13982720426/MimiVent-firmware/CHANGELOG.md

# 更新记录

## [0.7.0] - 2026-11-13

- 版本从主分支 `v0.6.0` 递增；该版本汇总开发期尚未进入主分支的 MQTT、存储和 OTA 改进。
- 移除设备 HTTPS 服务及 TLS 资源开销；BLE 配网保留，WiFi 控制、查询和校时经本地 MQTT/NAS 完成，最低 App 版本设为 `v0.7.0`。
- MQTT 控制使用两阶段握手、短时凭据、设备去重记录和控制租约；改进 ACK、状态新鲜度、查询分片和查询槽释放，避免控制或分页查询被积压阻塞。
- 优化统计查询分片、状态上报和重连快照；修复统计时间校准及跨日活动归档问题，旧存储 schema 继续兼容迁移。
- 缩小 BLE OTA 队列及统计记录常驻内存，降低 MQTT 常驻时的堆压力；完整包 OTA 工作区降低内存需求，错误信息增加内存诊断值。
- 保持 OTA 包格式和分区布局兼容；统计存储 schema 8 兼容读取旧 schema 4/6/7。

## 开发阶段构建记录（未发布到主分支；版本号仅用于开发测试）

### 开发构建 [0.7.16] - 2026-11-11

- 统计存储 schema 8：DailyRecord 的 runtimeBuckets / activitySpanBuckets 由 uint32_t 收窄为 uint16_t。单小时最多 3600 秒，uint16 足够；异常计时超限时饱和到 65535 而不回绕。单日记录 312 B → 216 B，30 天常驻省 2,880 B。
- 读取侧兼容 schema 4/6/7/8：旧记录逐条读入局部变量后转换，CRC 仍按文件原始字节校验，不额外占用整块缓冲。
- 累计后静态 RAM 由 74,944 B 降到 72,064 B。
- 不改变 OTA 包格式或分区布局。

### 开发构建 [0.7.15] - 2026-11-11

- BLE OTA 控制队列改为专用 326 B 消息结构（原按 518 B 通用结构分配），8 格队列由 4,144 B 降到 2,608 B。
- OTA 数据队列深度 12 → 6、控制队列 8 → 3，合计再释放约 4.7 KB 常驻堆；协议窗口 window=4 保持不变。
- 控制指令接口保持 receiveControl(Message*) 不变，接收端按实际长度拷贝，上层无改动。
- ControlApi 响应新增右值重载，统计查询不再为整份响应额外分配一份堆副本。
- 新增 [mem] 周期日志（free/largest/min 同 capability），便于观察运行期内存基线。
- 不改变统计存储 schema、OTA 包格式或分区布局。

### 开发构建 [0.7.14] - 2026-11-11

- 最低 App 版本提升到 v0.7.6：设备 HTTPS 已于 0.7.12 移除，控制只能走 NAS MQTT，而 v0.7.6 是首个完整支持该通道的 App。旧 App 会在状态版本检查与旧式 BLE 请求两处收到 APP_UPDATE_REQUIRED。
- 完整包 OTA 块大小从 16 KB 降到 8 KB，总内存需求由约 43 KB 降到约 27 KB，避免在 MQTT 常驻 + BLE 连接时触发 ERROR|MEMORY。
- OTA 内存失败时错误码携带 block/free/largest 实际数字，便于区分容量不足与碎片。
- 不改变统计存储 schema、OTA 包格式或分区布局。

### 开发构建 [0.7.13] - 2026-11-11

- 统计查询回复分片从 128 B 提升到 1024 B。原先一份 2.5 KB 的统计要拆 20 片且每片都要等设备 ACK 才发下一片，统计页因此比控制慢一个数量级；现在片数降到 3 片。
- 单片载荷经核算为 1224 B，仍在 1536 B 单条上限内，不改变 MQTT 信封格式或分片协议。
- 不改变统计存储 schema、OTA 包格式或分区布局。

### 开发构建 [0.7.12] - 2026-11-09

- 蓝牙校时覆盖 NAS 来源后，当前 MQTT 会话会重新向 NAS 取时，避免停留在手机时间来源。

### 开发构建 [0.7.11] - 2026-11-07

- 统计响应新增当前启动内最近一次成功校时来源（phone/nas/none），方便区分 BLE 与 NAS MQTT 校时。
- 不改变统计存储 schema、OTA 包格式或分区布局。

### 开发构建 [0.7.10] - 2026-11-07

- 活动合并间隔和持续时间改用当前启动内的单调计时，避免校时回拨/跳变造成活动被拆分或时长错误。
- 日桶按活动起点 UTC 锚点加单调跨度映射；回拨时保留事件顺序并标记 `clockWentBackwards`。
- 统计存储 schema、OTA 包格式和分区布局不变。

### 开发构建 [0.7.9] - 2026-11-07

- 修正 MQTT 状态入队预算：为 1 KiB 状态负载额外预留 topic 与 MQTT 包头空间，避免消息在进入 outbox 前被持续拒绝。
- 为最大状态负载增加原生回归测试；控制回执仍保留独立队列预算。

### 开发构建 [0.7.8] - 2026-11-07

- MQTT 状态改用 schema 1 信封，携带 deviceId、bootId、32 位 seq 和单调 uptime；原状态字段保留在 state 内。
- 状态变化后快速上报，空闲时每 5 秒发送一次心跳；运行计时变化不推进状态序号。
- MQTT 重连后主动发布完整快照，超出 1 KiB 的状态拒绝发送并记录诊断。
- 统计 schema、OTA 包格式及分区布局不变。

### 开发构建 [0.7.7] - 2026-11-07

- MQTT 两阶段控制的 HMAC challenge 密钥改为每次设备启动生成一次，避免短暂 MQTT 重连发生在 prepare/execute 之间时误报 `COMMAND_EXPIRED`。
- 保持 challenge 的 1 秒有效期、绑定 token 校验、去重与统计 schema 不变。

### 开发构建 [0.7.6] - 2026-11-07

- 删除 ESP32 HTTPS 服务、TLS 资源探针及专属构建包装；BLE 配网保留，WiFi 控制与读取仅经 MQTT/NAS。
- 将 MQTT 写控制、绑定更新及去重恢复移到独立控制服务，不再依赖 HTTP 服务生命周期。
- WiFi 状态返回 MQTT 配置和连接状态；现场绑定/OTA 回归脚本据此等待 MQTT 就绪。
- 保持统计 schema、OTA 包格式及分区布局不变；本版本已部署到真机。

### 开发构建 [0.7.5] - 2026-11-07

- MQTT-only 构建的设备能力明确声明 MQTT 控制、只读查询和校时，不再把它们错误绑定到已关闭的板载 HTTPS 服务。
- 设备能力描述编译期支持；在线状态继续由独立连接字段表达。
- NAS 仅提供 UTC 与时间质量，不再把主机时区传给设备；统计时区未由 BLE/授权流程固定前，设备延迟采纳 NAS 校时。
- 统计 schema、OTA 包格式和分区布局不变。

### 开发构建 [0.7.4] - 2026-11-07

- MQTT 只读统计响应改为 128 字节分片、逐片确认，支持最多 8 KiB 的 JSON 响应并限制单包在 1 KiB 内。
- 统计响应在设备侧转移字符串所有权，避免为大响应额外解析出一棵完整 cJSON 树。
- 统计 schema、OTA 包格式和分区布局不变。

### 开发构建 [0.7.3] - 2026-11-07

- NAS MQTT 两阶段控制增加定时设置保存；继续复用绑定授权、短时 challenge、写入去重和控制互斥锁。
- 统计 schema、OTA 包格式和分区布局不变。

### 开发构建 [0.7.2] - 2026-11-07

- BLE OTA 分配签名包解码工作区前主动释放 MQTT 客户端和队列堆占用，恢复路径仍由主循环自动重连。
- OTA 开始前登记当前授权 BLE 会话为任务 owner，内存准备失败时仍可查询明确终态，不遗留 `NOT_OWNER`。
- 统计 schema、OTA 包格式和分区布局不变。

### 开发构建 [0.7.1] - 2026-11-07

- MQTT 状态心跳调整为 5 秒，并在状态快照中携带有效绑定的 token 哈希摘要，供 NAS 续期只读缓存授权；不发送明文 token。
- 保持设备 HTTPS 在 WiFi/MQTT 构建中关闭；MQTT 发送队列仍为有界，控制 ACK 保留预算。
- 统计 schema 与 OTA 分区布局不变。

### 开发构建 [0.7.0] - 2026-11-06

- 修复 NAS 控制因 NVS 去重记录空间不足返回 503：迁移到 statistics 文件分区独立双槽，写后校验再执行，保留原有配置及统计数据。
- BLE + MQTT 构建关闭设备 HTTPS，减少通信内存占用；NAS 不可用时使用蓝牙。

- 增加局域网 NAS MQTT 控制，BLE 配置 Broker，设备计时签发短时凭据并校验订阅就绪状态。
- MQTT 与 HTTPS 共用控制租约和持久去重记录；增加正文摘要校验，兼容旧记录查询。
- 限制 MQTT 发送队列占用，记录入队失败，避免网络积压影响本地自动控制。
- 保持统计 schema 7 和现有 OTA 分区布局，保留 WiFi/BLE 直连能力。

## [0.6.0] - 2026-11-05

### 变更
- 统计存储 schema 6 → 7：事件容量由 512 降到 256，快照字节数 19,656 → 14,536。
- 升级时自动迁移：按旧上限读取 schema 6 快照、截断到 256 条后按新布局落盘，30 天日汇总完整保留。
- 事件明细实际覆盖范围约 3 天，App 的明细入口同步收敛到今天/昨天/前天。
- 入厕样本时长改取该次排风对应的感应活动跨度，不再用排风时长；无前置活动时不计样本。
- 排风开始时快照活动跨度，避免排风期间 PIR 再次触发把这次样本清零。
- 跨午夜的活动整段归入开始日，入厕样本同样按活动开始日归属，日汇总与样本不再落在不同日期。

### 修复
- schema 6 → 7 缩容迁移保留最新 256 条事件，丢弃头部记录时推进 droppedThrough，全部原始事件仍参与 CRC 校验。
- 范围统计响应补充 deviceId/dataEpoch，供 App 隔离设备和统计批次缓存。
- 统计范围查询响应精简为短键（`cov/bits/rt/span/trig/seg`），不可用字段整段省略，单日响应约 5.1 KB 降到 3 KB。
- WiFi HTTPS 服务的堆门槛由 56 KB 降到 48 KB，TLS 栈 16 KB 降到 10 KB，双栈驻留时不再握手失败。
- 事件数组缩小后空闲堆由 18 KB 提升到 42 KB，`largest` 由 7.7 KB 提升到 32 KB。
- 固件要求的最低 App 版本提升到 0.6.0（更早的 App 不认识短键统计 JSON，会把所有桶读成 0）。

## [0.5.1] - 2026-11-04

### 修复
- WiFi 绑定记录从 2 槽 v1 格式无损迁移到 3 槽 v2 格式，升级后保留现有两台手机绑定。
- 第 3 个 WiFi 客户端可正常绑定；第 4 个才返回 `BINDINGS_FULL`。

### 变更
- 统计响应增加 toiletAverageSeconds 和 toiletSampleCount，按全部自动排风有效样本汇总平均入厕时间。
- 设备端 WiFi 绑定上限由 2 个提升到 3 个。

## [0.5.0] - 2026-11-03

本节汇总自正式版 v0.4.0 以来的变化；开发调试版本不单独列为正式发布。本次版本已完成用户真机验证。

### 新增

- WiFi STA 配网，通过加密且已 bonding 的独立 BLE 服务下发凭据，NVS 保存、开机恢复；附近网络由手机搜索，设备端不执行 WiFi 扫描。
- HTTPS 8443 局域网控制，状态、时序设置、风机操作、统计及事件查询复用 `ControlApi`，并提供写请求 ID 去重与执行结果查询。
- 持久设备身份、证书与 token 认证，最多三个有效绑定，支持绑定窗口、待绑定、核验、幂等提交、逐个撤销和安全 BLE 清除全部绑定。
- WiFi 单控制者租约与 BLE 业务协调，租约空闲 20 秒过期，支持主动释放、另一手机接管和绑定重置后释放。
- 自动排风记录保存设定时长，统计接口增加 `toiletCount` 估算；实际自动排风达到设定时长一半时计入，手动/强制排风排除。

### 优化与修正

- 提供项目构建模式与隔离 TLS 4 KiB SDK 副本校验，控制 BLE/WiFi 共存资源占用，不覆盖全局 SDK；完整 WiFi 控制使用 `read4k` 模式。
- OTA 工作区按需分配，内存不足时释放 HTTPS、必要时暂停 WiFi；暂停及升级流程结束后恢复网络服务，保留原有签名与分区校验。
- 安全 BLE 与普通控制请求隔离、会话关联及有界响应，改善配对、重连、通知超时后的恢复。
- USB CDC 日志采用非阻塞输出，避免主机不读取串口时拖慢 BLE 初始化和响应。
- HTTPS 单连接及有界请求调度、WiFi 省电策略和租约协调，减少多手机竞争、控制延迟和资源占用。
- WiFi 身份与绑定持久化、存储余量检查及显式维护入口，避免创建绑定挤占 OTA 检查点空间；敏感凭据不写日志。

### 兼容与限制

- 最低 BLE v2 App 仍为 0.3.0；完整配网、WiFi 控制与统计展示配套 App v0.5.0。
- 保留 schema 4、双槽统计、30 天汇总和最多 10 天/512 条明细；预计入厕依赖仍保留的自动排风记录，不是独立永久日汇总。
- 保留 v0.4.0 的签名完整/压缩/差分 BLE OTA、暂停续传、独立安装与重连核验；本版不提供 WiFi OTA、SoftAP 网页或云端控制。

## [0.4.0] - 2026-10-30

- 修复备用槽已有固件时的 OTA 续传擦除；能力与镜像信息查询不再覆盖任务状态，QUERY 可恢复待安装结果及失败原因。
- 统计格式升级为 schema 4：每小时独立累计运行时长，汇总和各范围图表从同一组小时桶生成；超过 512 条明细后仍保留完整运行汇总，接口返回明细截断标记。
- 独立保存当前运行身份，避免 PIR 明细淘汰导致停止时漏结算；优先保留待校时运行记录，首次校时可回填。
- 开发期旧格式统计在首次启动 schema 4 时重建，并切换 dataEpoch；设备设置与 OTA 任务保留。

- 从正式版 v0.3.1 首次迁移到新分区布局和 BLE OTA V2 时需通过 USB 烧录；后续版本可经 App 无线升级。
- 固件声明最低兼容 App 为 `0.3.0`；旧 BLE v1 请求返回 `426 APP_UPDATE_REQUIRED`。控制协议切换为 BLE v2。
- BLE OTA 采用签名包、流控窗口、完整校验、独立安装确认和重连身份核验；断连后以设备有效检查点续传。
- 增加 OTA 分区运行时串口清单，便于验收实际生效的分区布局与目标 OTA 槽。
- 修复设备回滚状态被连接初始化覆盖的问题；查询时从持久拒绝记录恢复回滚任务身份。
- 修复安装意图写入后、启动槽切换前断电会误拒绝放弃/替换的问题；根据实际启动分区判断是否已提交安装。

### 修正
- 修复 miniz 解压头文件格式，恢复固件编译。
- OTA 压缩包与差分包头改为按声明长度安全解析版本和分区字段。
- 统计时区在首次可信校时后固定，避免手机时区变化重解释历史日汇总。
- 今日事件窗口使用本地自然日，接口返回固定查询起止时间；昨日继续使用前一自然日。
- 首次验证和时序配置说明改为使用 MimiVent App 的 BLE 流程。

### 新增
- 移除设备 SoftAP、HTTP 控制台及固件内嵌网页，设备控制统一使用 BLE；为后续 Wi-Fi STA 传输层保留公共业务接口。
- 事件记录新增单调递增 ID 和 `beforeId` 游标分页，旧版 SPIFFS 统计数据迁移 ID 时保留历史；事件 API 返回稳定游标并兼容旧 App 的 `offset` 参数。
- 增加 BLE OTA 固件升级，镜像分块写入备用 OTA 应用槽，逐块校验 CRC-32，完成后校验 SHA-256。
- App 可选择并识别 MimiVent ESP32-C3 固件镜像，显示传输进度；升级失败、超时或 BLE 断开时中止并恢复自动感应。
- OTA 期间风机强制关闭，镜像通过设备型号校验后才写入；通过 `OtaManager` 隔离升级会话，后续网络传输可复用同一写入核心。
- OTA 操作需要已连接的 BLE 会话及 App 内二次确认；升级过程中请保持 App 前台并靠近设备。

## [0.3.1] - 2026-10-28

### 修正
- 今日事件窗口按本地自然日查询，支持固定范围分页。
- 统计事件按 `mode` 参数返回：今日使用当前本地自然日，昨日使用前一自然日；App 可按稳定游标继续分页读取窗口内仍保留的原始事件。
- 新增通用 `GET /api/events`，可按 Unix 时间起止、事件类型和 ID 游标查询任意时间范围内的原始记录；BLE 与 HTTP 共用该查询。
- 手动恢复自动感应时记录恢复事件，便于 App 计算临时暂停和持续关闭被提前结束时的实际时长。
- `/api/status` 增加 `minimumAppVersion`，用于声明当前固件支持完整功能所需的最低 App 版本。
- 事件统计补齐临时暂停和持续关闭操作；暂停记录设定时长，持续关闭标记为需手动恢复。

## [0.3.0] - 2026-10-27

### 新增
- 增加 SPIFFS 双槽统计存储，按日汇总最长保留 365 天，事件明细保留最近 30 天。
- 增加手机时间校准和今日、昨日、近 3 天、近 7 天统计 API。
- 校时前的本次开机事件会在首次校时后补入对应日期；重启前未校时的数据无法可靠还原日期。

### 修正
- 继电器关闭 GPIO 初始化提前到 SPIFFS 统计存储初始化之前。
- 统计文件系统已初始化后若挂载失败，不再自动格式化并清空历史数据。
- 统计运行时文案统一为风机总运行时长，包含自动、临时和强制排风。

### 验证
- 使用 ESP32 Arduino core 3.3.12 和 `Minimal SPIFFS` 分区编译通过；USB 烧录并逐段校验通过。

本项目从首个正式版本 `v0.1.0` 开始采用语义化版本管理。此前提交用于硬件验证与网页调试。

## [0.2.0] - 2026-10-23

### 新增
- 增加 BLE GATT 控制通道与 HTTPS 网页客户端，网页命令和 Wi-Fi HTTP 共用 `ControlApi` 业务接口。
- 显式将 `MimiVent` 设备名加入 BLE 扫描响应，改善首次扫描时设备名称显示。
- 将网页源文件独立为 `web/index.html`，通过 gzip 资源嵌入固件，并提供同步生成脚本。
- 增加 BLE 连接/断开状态、请求超时处理；BLE 客户端不读取 Wi-Fi 密码。
- 将 BLE 网页请求串行排队，避免页面初始化和状态轮询并发时误报连接中断。
- 对 HTTP 与 BLE 的时序配置输入执行严格数字和选项校验，非法值返回错误，不再被转换为 0。
- 根据控制入口区分连接信息：HTTPS/静态 BLE 页面隐藏本地 IP 与 Wi-Fi 凭据，设备热点网页保留这些信息。

### 验证说明
- ESP32-C3 固件编译通过；用户已确认静态网页显示和入口信息符合预期。
- BLE 网页曾在 macOS 本地静态页面完成连接和控制；本次请求串行修复及非法时序输入拒绝逻辑已通过编译，未在本次更新后重新烧录实机回归。

### 已知限制
- HTTPS 托管页面的 Web Bluetooth 兼容性取决于手机浏览器；目标手机兼容性及 BLE 与 Wi-Fi AP 长时间并行稳定性尚未验证。
- 默认应用分区占用接近 99%，后续固件增量空间有限。

## [0.1.0] - 2026-10-22

### 新增
- 发布首个可维护版本，使用 ESP32-C3-DevKitM-1、单 PIR、继电器和 12V 风机实现猫砂盆自动排风。
- 将固件拆分为配置、时序存储、风机状态机、Wi-Fi 热点、网页控制台和状态灯模块。
- 增加本地 AP 控制页面、固件版本显示、运行状态与倒计时展示。
- 增加正式/DEV 两套可调整并分别保存到 NVS 的时序配置，以及共用时间滚轮和当前环境配置重置。
- 增加定时临时排风、临时暂停、强制排风测试和二次确认的持续关闭操作。
- 增加 README、语义化版本头文件和构建产物忽略规则。

### 修改
- PIR 活动时立即停止风机；PIR 连续 LOW 达到离开确认时间后运行完整排风周期，期间再次检测到活动会停风并重新确认。
- 正式启动冷静期默认 30 秒，DEV 默认 5 秒；强制排风测试与持续关闭可跳过冷静期。
- 页面与设备环境不匹配时锁定控制；连接状态点按连接中、在线和中断显示灰、绿、红色。
- 定时操作切换前要求确认，避免旧任务排队或被重复点击重置。
