13982720426/MimiVent-firmware/ControlApi.cpp

// 统一维护设备业务规则，传输层只负责解析请求和发送响应。
#include "ControlApi.h"
#include "WifiCapabilities.h"

#include <cstdio>
#include <cstdlib>
#include <utility>
#include <freertos/FreeRTOS.h>
#include <freertos/semphr.h>

#include "AppConfig.h"
#include "FanController.h"
#include "FirmwareVersion.h"
#include "OtaManager.h"
#include "StatisticsStore.h"
#include "AppConfig.h"
#include "WifiProvisioningManager.h"

namespace {

SemaphoreHandle_t controlMutex = nullptr;

bool lockOffArmed = false;
unsigned long lockOffArmedMs = 0;
TimingProfile lockOffProfile = TimingProfile::PRODUCTION;

ControlApiResponse response(uint16_t code, const char* type, const String& body) {
  return {code, type, body};
}

// 右值重载：把响应体直接移进返回对象，避免为整份响应再分配一次堆副本。
// 统计查询的响应体最大可达数 KB，复制一份会显著抬高峰值占用。
// 调用方传临时对象（如 statisticsStoreBuildJson(...)）时自动走这条路径。
ControlApiResponse response(uint16_t code, const char* type, String&& body) {
  return {code, type, std::move(body)};
}

ControlApiResponse jsonError(uint16_t code, const char* message) {
  String body = "{\"error\":\"";
  body += message;
  body += "\"}";
  return response(code, "application/json; charset=utf-8", body);
}

ControlApiResponse jsonOk(const char* body = "{\"ok\":true}") {
  return response(200, "application/json; charset=utf-8", body);
}

bool profileMatches(TimingProfile requested) {
  return fanControllerGetStatus(millis()).activeProfile == requested;
}

bool replacementAllowed(bool replace) {
  return !fanControllerHasInterruptibleTask() || replace;
}

bool parseUnsignedParameter(const String& value, unsigned long* parsed) {
  if (!value.length()) return false;
  char* end = nullptr;
  const unsigned long result = strtoul(value.c_str(), &end, 10);
  if (end == value.c_str() || *end != '\0') return false;
  *parsed = result;
  return true;
}

String formValue(const String& body, const char* key) {
  const String prefix = String(key) + "=";
  int start = 0;
  while (start < body.length()) {
    const int end = body.indexOf('&', start);
    const String item = end < 0 ? body.substring(start) : body.substring(start, end);
    if (item.startsWith(prefix)) return item.substring(prefix.length());
    if (end < 0) break;
    start = end + 1;
  }
  return String();
}

ControlApiResponse statusResponse(TimingProfile viewProfile) {
  const FanControllerStatus status = fanControllerGetStatus(millis());
  const TimingSettings active = settingsStoreGet(status.activeProfile);
#if MIMIVENT_ENABLE_WIFI
  const char* kCapabilities =
      wifiCapabilitiesJson(true, MIMIVENT_WIFI_READ_CONTROL != 0);
  constexpr uint8_t kGattVersion = 2;
#else
  const char* kCapabilities = wifiCapabilitiesJson(false, false);
  constexpr uint8_t kGattVersion = 1;
#endif
  // 新增 storageSchema / minReadableStorageSchema 后需重新核算长度，避免被 snprintf 截断。
  char payload[1024];
  snprintf(payload, sizeof(payload),
           "{\"fan\":%s,\"pir\":%s,\"mode\":\"%s\",\"phase\":\"%s\","
           "\"activeProfile\":\"%s\",\"viewProfile\":\"%s\",\"fanRunMs\":%lu,"
           "\"remainingMs\":%lu,\"durationMs\":%lu,\"phaseDurationMs\":%lu,\"startupCooldownMs\":%lu,\"leaveConfirmMs\":%lu,"
           "\"autoExhaustMs\":%lu,\"manualExhaustMs\":%lu,\"pauseMs\":%lu,\"firmware\":\"%s\",\"minimumAppVersion\":\"%s\",\"statisticsSchema\":%u,"
           "\"storageSchema\":%u,\"minReadableStorageSchema\":%u,\"statsRangeApiVersion\":2,"
           "\"tzOffsetSeconds\":%ld,"
           "\"capabilities\":%s,\"gattVersion\":%u}",
           status.fanOn ? "true" : "false", status.presenceDetected ? "true" : "false",
           fanControllerModeName(), fanControllerPhaseName(),
           settingsStoreProfileName(status.activeProfile), settingsStoreProfileName(viewProfile),
           status.fanRunMs, status.remainingMs, status.overrideDurationMs, status.phaseDurationMs,
           active.startupCooldownMs, active.leaveConfirmMs, active.autoExhaustMs,
           active.manualExhaustMs, active.pauseMs, FIRMWARE_VERSION, FIRMWARE_MINIMUM_APP_VERSION,
           statisticsSchemaCompatVersion(), statisticsStoreSchemaVersion(),
           statisticsStoreMinReadableSchemaVersion(),
           static_cast<long>(statisticsStoreTimezoneOffsetSeconds()),
           kCapabilities, kGattVersion);
  return response(200, "application/json; charset=utf-8", payload);
}

ControlApiResponse settingsResponse(TimingProfile profile) {
  const TimingSettings settings = settingsStoreGet(profile);
  char payload[180];
  snprintf(payload, sizeof(payload),
           "{\"profile\":\"%s\",\"startupCooldownMs\":%lu,\"leaveConfirmMs\":%lu,\"autoExhaustMs\":%lu,"
           "\"manualExhaustMs\":%lu,\"pauseMs\":%lu}",
           settingsStoreProfileName(profile), settings.startupCooldownMs, settings.leaveConfirmMs,
           settings.autoExhaustMs, settings.manualExhaustMs, settings.pauseMs);
  return response(200, "application/json; charset=utf-8", payload);
}

ControlApiResponse timedResponse(const ControlApiRequest& request) {
  if (!profileMatches(request.profile)) return jsonError(409, "PROFILE_MISMATCH");
  if (!replacementAllowed(request.replace)) return jsonError(409, "当前有限时任务，请先确认停止并切换");
  if (fanControllerIsStartupCoolingDown()) return jsonError(423, "STARTUP_COOLDOWN");
  if (request.mode != "on" && request.mode != "off") return jsonError(400, "mode must be on or off");

  fanControllerSetProfile(request.profile);
  const TimingSettings settings = settingsStoreGet(request.profile);
  const unsigned long nowMs = millis();
  if (request.mode == "on") {
    if (!fanControllerStartTimedExhaust(settings.manualExhaustMs, nowMs)) {
      return jsonError(409, "PIR_HIGH");
    }
  } else {
    fanControllerStartTimedPause(settings.pauseMs, nowMs);
  }
  return jsonOk();
}

ControlApiResponse autoResponse(const ControlApiRequest& request) {
  if (!profileMatches(request.profile) && !request.switchProfile) {
    return jsonError(409, "PROFILE_MISMATCH");
  }
  if (!replacementAllowed(request.replace)) return jsonError(409, "当前有限时任务，请先确认停止并切换");
  fanControllerSetProfile(request.profile);
  fanControllerSetAuto(millis());
  return jsonOk();
}

ControlApiResponse lockOffResponse(const ControlApiRequest& request) {
  const unsigned long nowMs = millis();
  if (request.stage == "prepare") {
    if (!profileMatches(request.profile)) return jsonError(409, "PROFILE_MISMATCH");
    lockOffArmed = true;
    lockOffArmedMs = nowMs;
    lockOffProfile = request.profile;
    return jsonOk("{\"armed\":true}");
  }
  if (request.stage == "cancel") {
    lockOffArmed = false;
    return jsonOk();
  }
  if (request.stage != "confirm") return jsonError(400, "invalid stage");
  if (!lockOffArmed || nowMs - lockOffArmedMs > 15000UL) {
    lockOffArmed = false;
    return jsonError(409, "confirmation expired");
  }
  if (!profileMatches(lockOffProfile)) {
    lockOffArmed = false;
    return jsonError(409, "PROFILE_MISMATCH");
  }
  if (!replacementAllowed(request.replace)) return jsonError(409, "当前有限时任务，请先确认停止并切换");
  lockOffArmed = false;
  fanControllerSetProfile(lockOffProfile);
  fanControllerSetLockedOff(nowMs);
  return jsonOk();
}

}  // namespace

void controlApiBegin() {
  if (!controlMutex) controlMutex = xSemaphoreCreateMutex();
}

void controlApiLock() {
  if (controlMutex) xSemaphoreTake(controlMutex, portMAX_DELAY);
}

void controlApiUnlock() {
  if (controlMutex) xSemaphoreGive(controlMutex);
}

ControlApiResponse controlApiDispatch(const ControlApiRequest& request) {
  struct Guard {
    Guard() { controlApiLock(); }
    ~Guard() { controlApiUnlock(); }
  } guard;
  if(request.hasDeadline&&uint32_t(millis()-request.issuedAtMs)>request.maxAgeMs)
    return {409,"application/json","{\"error\":\"COMMAND_EXPIRED\"}"};
  if (request.path == "/api/status" && request.method == "GET") return statusResponse(request.profile);
  if (request.path == "/api/events" && request.method == "GET") {
    // OTA 期间拒绝统计查询：两侧各需近 10-19 KB 连续堆，叠加会挤爆。
    if (otaManagerIsActive()) return jsonError(423, "OTA_BUSY");
    unsigned long start = 0;
    unsigned long end = 0;
    unsigned long offset = 0;
    unsigned long beforeId = 0;
    unsigned long limit = 32;
    if (!parseUnsignedParameter(request.eventStart, &start) ||
        !parseUnsignedParameter(request.eventEnd, &end) || start >= end ||
        end > 0xFFFFFFFFUL) {
      return jsonError(400, "INVALID_EVENT_RANGE");
    }
    if (request.eventOffset.length() &&
        (!parseUnsignedParameter(request.eventOffset, &offset) || offset > 512UL)) {
      return jsonError(400, "INVALID_EVENT_OFFSET");
    }
    if (request.eventBeforeId.length() &&
        (!parseUnsignedParameter(request.eventBeforeId, &beforeId) || beforeId == 0)) {
      return jsonError(400, "INVALID_EVENT_CURSOR");
    }
    if (request.eventLimit.length() &&
        (!parseUnsignedParameter(request.eventLimit, &limit) || limit < 1 || limit > 32)) {
      return jsonError(400, "INVALID_EVENT_LIMIT");
    }
    const String kind = request.eventKind.length() ? request.eventKind : "all";
    if (kind != "all" && kind != "activity" && kind != "automatic" &&
        kind != "manual" && kind != "force" && kind != "pause" &&
        kind != "locked_off" && kind != "resume") {
      return jsonError(400, "INVALID_EVENT_KIND");
    }
    if (request.eventDataEpoch.length() &&
        request.eventDataEpoch != statisticsStoreDataEpoch()) {
      return jsonError(409, "DATASET_CHANGED");
    }
    const FanControllerStatus status = fanControllerGetStatus(millis());
    return response(200, "application/json; charset=utf-8",
                    statisticsStoreBuildEventsJson(
                        static_cast<uint32_t>(start), static_cast<uint32_t>(end), kind,
                        static_cast<uint16_t>(offset), static_cast<uint8_t>(limit),
                        status.fanRunMs, static_cast<uint32_t>(beforeId)));
  }
  if (request.path == "/api/stats/range" && request.method == "GET") {
    if (otaManagerIsActive()) return jsonError(423, "OTA_BUSY");
    unsigned long rangeFrom = 0;
    unsigned long rangeTo = 0;
    if (!parseUnsignedParameter(request.rangeFrom, &rangeFrom) ||
        !parseUnsignedParameter(request.rangeTo, &rangeTo) || rangeFrom >= rangeTo) {
      return jsonError(400, "INVALID_RANGE");
    }
    long offsetSeconds = 0;
    {
      const char* text = request.rangeTz.c_str();
      char* end = nullptr;
      offsetSeconds = strtol(text, &end, 10);
      if (!request.rangeTz.length() || end == text || *end != '\0' ||
          offsetSeconds < -43200L || offsetSeconds > 50400L) {
        return jsonError(400, "INVALID_RANGE");
      }
    }
    uint8_t rangeError = 0;
    String body = statisticsStoreBuildRangeJson(
        static_cast<uint32_t>(rangeFrom), static_cast<uint32_t>(rangeTo),
        static_cast<int32_t>(offsetSeconds), &rangeError);
    switch (static_cast<StatisticsRangeError>(rangeError)) {
      case StatisticsRangeError::kInvalidRange: return jsonError(400, "INVALID_RANGE");
      case StatisticsRangeError::kRangeTooLarge: return jsonError(400, "RANGE_TOO_LARGE");
      case StatisticsRangeError::kRangeOutOfRetention:
        return jsonError(400, "RANGE_OUT_OF_RETENTION");
      case StatisticsRangeError::kTimezoneMismatch:
        return jsonError(409, "TIMEZONE_MISMATCH");
      case StatisticsRangeError::kNotReady: return jsonError(503, "STATS_NOT_READY");
      case StatisticsRangeError::kNone: break;
    }
    // body 到这里已无其它持有者，移进响应避免再复制一整份统计结果。
    return response(200, "application/json; charset=utf-8", std::move(body));
  }
  if (request.path == "/api/stats" && request.method == "GET") {
    if (otaManagerIsActive()) return jsonError(423, "OTA_BUSY");
    const FanControllerStatus status = fanControllerGetStatus(millis());
    unsigned long eventOffset = 0;
    if (request.eventOffset.length()) {
      char* end = nullptr;
      eventOffset = strtoul(request.eventOffset.c_str(), &end, 10);
      if (end == request.eventOffset.c_str() || *end != '\0' || eventOffset > 512UL) {
        return jsonError(400, "INVALID_EVENT_OFFSET");
      }
    }
    unsigned long eventLimit = 32;
    if (request.eventLimit.length() &&
        (!parseUnsignedParameter(request.eventLimit, &eventLimit) ||
         eventLimit < 1 || eventLimit > 32)) {
      return jsonError(400, "INVALID_EVENT_LIMIT");
    }
    return response(200, "application/json; charset=utf-8",
                    statisticsStoreBuildJson(request.mode, status.fanOn, status.fanRunMs,
                                             static_cast<uint16_t>(eventOffset),
                                             static_cast<uint8_t>(eventLimit)));
  }
  if (request.path == "/api/time" && request.method == "POST") {
    const String epochText = formValue(request.body, "unixTime");
    const String offsetText = formValue(request.body, "utcOffsetMinutes");
    if (!epochText.length() || !offsetText.length()) return jsonError(400, "TIME_REQUIRED");
    char* end = nullptr;
    const unsigned long epoch = strtoul(epochText.c_str(), &end, 10);
    if (end == epochText.c_str() || *end != '\0') return jsonError(400, "INVALID_TIME");
    const long offset = strtol(offsetText.c_str(), &end, 10);
    if (end == offsetText.c_str() || *end != '\0' || offset < -720 || offset > 840) {
      return jsonError(400, "INVALID_TIMEZONE_OFFSET");
    }
    if (!statisticsStoreClockSyncSafe()) return jsonError(409, "TIME_SYNC_DEFERRED");
    if (!statisticsStoreSetClockFromSource(epoch, static_cast<int16_t>(offset),
                                           StatisticsClockSource::kPhone)) {
      return jsonError(409, "TIME_SYNC_CONFLICT");
    }
    return jsonOk("{\"synced\":true}");
  }
  if (request.path == "/api/settings" && request.method == "GET") return settingsResponse(request.profile);
  if (request.path == "/api/settings" && request.method == "POST") {
    if (!profileMatches(request.profile)) return jsonError(409, "PROFILE_MISMATCH");
    if (!request.hasSettings) return jsonError(400, "all five timing settings are required");
    if (!settingsStoreSave(request.profile, request.settings)) {
      return jsonError(400, "timing value is not in the allowed options");
    }
    return jsonOk();
  }
  if (request.path == "/api/settings/reset" && request.method == "POST") {
    if (!profileMatches(request.profile)) return jsonError(409, "PROFILE_MISMATCH");
    if (!settingsStoreReset(request.profile)) return jsonError(500, "failed to reset timing settings");
    return jsonOk();
  }
  if (request.path == "/api/timed" && request.method == "POST") return timedResponse(request);
  if (request.path == "/api/test-fan" && request.method == "POST") {
    if (!profileMatches(request.profile)) return jsonError(409, "PROFILE_MISMATCH");
    if (!replacementAllowed(request.replace)) return jsonError(409, "当前有限时任务，请先确认停止并切换");
    fanControllerSetProfile(request.profile);
    fanControllerStartForceTest(settingsStoreGet(request.profile).manualExhaustMs, millis());
    return jsonOk();
  }
  if (request.path == "/api/auto" && request.method == "POST") return autoResponse(request);
  if (request.path == "/api/lockoff" && request.method == "POST") return lockOffResponse(request);
  return jsonError(404, "Not found");
}

bool controlApiParseTimeValue(const String& value, bool allowZero, unsigned long* parsedValue) {
  if (parsedValue == nullptr || !value.length()) return false;

  // 页面最大选项为 10 分钟；逐位解析并在运算前限幅，拒绝符号、后缀和溢出值。
  constexpr unsigned long kMaximumAllowedTimeMs = 600000UL;
  unsigned long result = 0;
  for (size_t index = 0; index < value.length(); ++index) {
    const char character = value[index];
    if (character < '0' || character > '9') return false;
    const unsigned long digit = static_cast<unsigned long>(character - '0');
    if (result > (kMaximumAllowedTimeMs - digit) / 10UL) return false;
    result = result * 10UL + digit;
  }

  if (!settingsStoreIsAllowedTime(result, allowZero)) return false;
  *parsedValue = result;
  return true;
}
