13982720426/MimiVent-firmware/(commit log)

2026-10-21 feat: 红外感应和状态灯demo
2026-10-21 feat: 风机红外联调demo
2026-10-21 feat: 本地网页调试demo
2026-10-29 release: MimiVent firmware v0.4.0
    [partitions.csv]
